Stab-Rabbit-coding/LibreServo_v4/PCB/RS485-CANFD-TPM-upgrade.md

# Hardware upgrade notes: isolated RS-485, isolated CAN-FD, TPM (SLB9672), MCU swap to STM32G431

> **Superseded again, 2026-08-10:** `U7` is now an Infineon OPTIGA™ Trust M V3
> secure element, not a TPM and not absent. See
> [`OPTIGA-Trust-M-secure-element.md`](OPTIGA-Trust-M-secure-element.md).

**Superseded in part**: the STM32G431 (`U1`) and the SLB9672 TPM (`U7`) described in §4/§5 below have since been replaced — `U1` is now an NXP S32K144, and `U7`/SLB9672 has been removed in favor of the S32K144's on-chip CSEc. See [`S32K144-MCU-swap.md`](S32K144-MCU-swap.md) for that pass. The isolated RS-485 (§2, `U5`/ADM2587E) and isolated CAN-FD (§3, `U6`/ADM3055E) content below is still current.

Engineering analysis and part recommendations for the LibreServo v2.3.1 board (`PCB/LibreServo-v2.3.1.sch`, MCU `U1`). This is a decision record and BOM proposal, not yet reflected in the EAGLE `.sch`/`.brd` files — see "Status / next steps" at the bottom for why, and what's needed to finish the layout.

**Decision: MCU is being swapped to STM32G431** (native FDCAN) — see §5. This is the bigger of the two alternatives originally laid out, chosen over adding an external MCP2518FD controller to the existing STM32F302K8U6.

Local datasheet copies for the three parts driving this change are in [`datasheets/`](datasheets/):

- [`ADM2582E-ADM2587E.pdf`](datasheets/ADM2582E-ADM2587E.pdf) — isolated RS-485 transceiver (§2)
- [`ADM3055E-ADM3057E.pdf`](datasheets/ADM3055E-ADM3057E.pdf) — isolated CAN-FD transceiver (§3)
- [`Infineon-SLB9672-TPM2.0-SPI-FW16.xx-datasheet.pdf`](datasheets/Infineon-SLB9672-TPM2.0-SPI-FW16.xx-datasheet.pdf) — TPM (§4)

## 1. MCU CAN-FD capability — verified: no (on the current `U1`, STM32F302K8U6)

`U1` is currently an **STM32F302K8U6** (STM32F302x6/x8 subfamily, Cat.2, UFQFPN32, 64 KB Flash) per `Test_LibreServo_v2.ioc`. This subfamily includes ST's classic **bxCAN** peripheral (CAN 2.0B, up to 1 Mbit/s, 8-byte frames only) — it does **not** implement **FDCAN** (the flexible-data-rate peripheral with BRS and up to 64-byte frames). FDCAN was introduced later, starting with the STM32F7/G0/G4/H7/L5 families ([AN5348, "Introduction to FDCAN peripherals for STM32 MCUs"](https://www.st.com/resource/en/application_note/an5348-introduction-to-fdcan-peripherals-for-stm32-mcus-stmicroelectronics.pdf) lists which families have it — F3 is not one of them).

Practically, this was moot either way for the *current* board: the schematic doesn't route `U1`'s CAN pins anywhere and there's no CAN transceiver in the BOM — CAN is unused silicon on this design today. This is exactly why §5 resolves the gap by swapping to a family that has FDCAN natively, rather than bolting a CAN-FD controller onto silicon that never had CAN wired up in the first place.

**Naming discrepancy worth flagging**: `PCB/LibreServo-v2.3_BOM.txt` lists `U1` as `STM32F301K8U6`, not `STM32F302K8U6` as configured in the `.ioc`. Datasheet: [STM32F301C6](https://www.st.com/resource/en/datasheet/stm32f301c6.pdf) (STM32F301x6/x8 subfamily — same die family, no isolated local copy here as `st.com` isn't reachable from this session's network policy). The two subfamilies share the same bxCAN-only (no FDCAN) conclusion above either way, but whoever does the schematic/footprint pass for the STM32G431 swap (§5) should first confirm which part is actually populated on existing boards (F301 vs. F302 — F302 additionally has a comparator/op-amp/USB set F301 lacks) so the new part is compared against the right baseline.

## 2. Isolated RS-485 transceiver (replaces `U5`, SIT3485EUA)

Current part: `U5`, SIT3485 half-duplex RS-485, MSOP-8, no isolation — the daisy-chain bus (`U$8`/`U$9`, JST-PH-4) shares digital GND directly with every other servo on the chain today.

**Recommendation: Analog Devices [ADM2587E](https://www.analog.com/ADM2587E/datasheet)** (USA, local copy: [`datasheets/ADM2582E-ADM2587E.pdf`](datasheets/ADM2582E-ADM2587E.pdf)). Single-chip signal *and* power isolation (iCoupler + isoPower — no external isolated DC/DC needed), half/full-duplex configurable, ±15 kV ESD, 2.5 kV rms isolation, single 3.3 V or 5 V supply on the logic side, 20-lead wide-body SOIC.

Why this over a signal-only isolator (e.g. TI [ISO1176](https://www.ti.com/product/ISO1176)): board space on this design is very tight, and a signal-only part still needs a separate isolated bus-side supply (push-pull driver + transformer, or a small isolated DC/DC module) — more parts, more area, more failure modes, for a part that's smaller/cheaper only in isolation. If SOIC-20 footprint area turns out to be the binding constraint, ISO1176 + an isolated supply is the fallback.

**Note on what "isolated" actually buys here**: the JST-PH-4 daisy-chain connector carries `Vmot`/`GND` (shared power distribution across the chain) alongside A/B. Isolating the transceiver splits the MCU/digital-logic ground from the RS-485 bus-side reference, which cuts ground-loop coupling and protects against bus miswiring/surges — but it does **not** isolate one servo's power domain from the next, since `Vmot`/`GND` still run straight through the connector by design. True node-to-node galvanic isolation would need the power distribution reworked too; that's a materially bigger change and is out of scope unless you want it.

## 3. Isolated CAN-FD transceiver (new)

**Recommendation: Analog Devices [ADM3055E](https://www.analog.com/media/en/technical-documentation/data-sheets/adm3055e-adm3057e.pdf)** (USA, local copy: [`datasheets/ADM3055E-ADM3057E.pdf`](datasheets/ADM3055E-ADM3057E.pdf)). Same iCoupler/isoPower approach as the ADM2587E above — 5 kV rms signal+power isolation, single 5 V supply, ISO 11898-2:2016 compliant, rated to 5 Mbps CAN FD (up to 12 Mbps demonstrated), 20-lead increased-creepage SOIC.

Picking the same vendor/technology family as the RS-485 part (§2) is deliberate: both isolate power internally, so neither needs its own isolated DC/DC design, and the two parts share a design/verification approach (same iCoupler isolation barrier characterization, same qualification data).

Fallback if SOIC-20 area is a problem: TI [ISO1042](https://www.ti.com/lit/ds/symlink/iso1042.pdf) (signal-only isolation, needs an external isolated supply — same tradeoff as ISO1176 above).

## 4. TPM: Infineon SLB9672

[SLB9672](https://www.infineon.com/assets/row/public/documents/30/49/infineon-slb9672-tpm20-spi-fw16.xx-ds-rev1-3-2024-11-18-datasheet-en.pdf) (Germany/EU, local copy: [`datasheets/Infineon-SLB9672-TPM2.0-SPI-FW16.xx-datasheet.pdf`](datasheets/Infineon-SLB9672-TPM2.0-SPI-FW16.xx-datasheet.pdf)) — TPM 2.0, SPI up to 33 MHz, PG-UQFN-32 package, internal power management (no explicit standby control needed).

Connects to `U1` on **SPI1**. On the new STM32G431 (§5), SPI1 is dedicated to the TPM alone — FDCAN is a separate hardware peripheral with its own TX/RX pins, so there's no bus-sharing between the TPM and the CAN-FD interface as there would have been with the external-controller alternative. Needs one GPIO for `~CS` and ideally one for an interrupt/ready line if the firmware wants event-driven reads rather than polling.

**Pin-budget flag**: still worth a full pin audit once the STM32G431 package/pinout is finalized in EAGLE (motor gate drivers, ADC current sense, encoder, USART1, RGB LED, oscillator, FDCAN TX/RX, and now SPI1 + TPM CS/IRQ all need a home) — the G431 has more GPIO headroom than the F302K8 it's replacing, but it's not unlimited, especially if a similarly small package (e.g. K6/K8, UFQFPN32) is kept for footprint/size parity.

## 5. MCU swap: STM32G431 for native FDCAN

Since §1 confirmed the current `U1` (STM32F302K8U6) has no FDCAN peripheral, an isolated CAN-FD *transceiver* alone isn't sufficient — something has to run the CAN-FD protocol/arbitration. Two options were evaluated; **STM32G431 is the one being taken forward**.

**Decision: [STMicroelectronics STM32G431](https://www.st.com/resource/en/datasheet/stm32g431c6.pdf)** series (e.g. STM32G431K6/K8, UFQFPN32) — HQ Plan-les-Ouates, Switzerland, fabs in France/Italy, **EU**. Cortex-M4 @ up to 170 MHz, native FDCAN peripheral (hardware bit-timing, message RAM, no CPU-mediated SPI framing), and is ST's official successor line to F3 — see [AN5094, "Migrating between STM32F334/303 and STM32G431/G474/G491"](https://www.st.com/resource/en/application_note/an5094-migrating-between-stm32f334303-and-stm32g431g474g491-mcus-stmicroelectronics.pdf).

| | Pros | Cons |
| --- | --- | --- |
| **Design impact** | Hardware FDCAN = precise bit timing, higher achievable throughput, no CPU cycles spent bit-banging SPI framing; frees SPI1 for the TPM alone; more GPIO/peripheral headroom than the F302K8 for future features | Full MCU swap: new schematic symbol/footprint, PCB relayout, and a firmware port (clock tree, HAL/peripheral register differences, re-mapping ADC/TIM/USART pins for existing PID/curve-generation/current-sense code) — the biggest-impact item in this whole upgrade |
| **Sourcing / "reach"** | ST has deep, redundant EU + global distribution (Digi-Key, Mouser, Farnell/element14, RS Components, Arrow); G4 is a current mainstream family with a long support runway, not a legacy part being phased out | Bigger BOM/unit-cost delta than the external-controller alternative; verification/requalification effort (schematic, layout, firmware, EMC) is proportionally larger |
| **REACH/RoHS** | ST publishes REACH SVHC and RoHS declarations for this family as standard | — |

**Alternative considered, not chosen — external CAN-FD controller on the existing MCU**: [Microchip MCP2518FD](https://ww1.microchip.com/downloads/aemDocuments/documents/OTH/ProductDocuments/DataSheets/External-CAN-FD-Controller-with-SPI-Interface-DS20006027B.pdf) (Microchip Technology Inc., Chandler, Arizona, **USA**) — SPI CAN-FD controller, would have sat between `U1`'s SPI1 and the ADM3055E transceiver from §3, keeping the STM32F302K8U6 in place. Pros were smallest change/lowest risk (no MCU footprint or firmware-port rework) and equally solid US sourcing (Digi-Key/Mouser/Arrow/Newark, EAR99, standard REACH/RoHS declarations). Cons were SPI-bus contention/latency vs. a hardware peripheral, a bus shared with the TPM, and CPU overhead servicing SPI transactions per frame instead of DMA-into-a-peripheral-FIFO — the STM32G431's native FDCAN avoids all of that, which is why it was picked instead.

**On "UK-sourced"**: there isn't a UK fabless/IDM vendor making a comparable CAN-FD controller or MCU — UK-based semiconductor firms in this space are mostly IP licensors (e.g. Arm) rather than chip suppliers. If UK sourcing specifically matters (e.g. procurement policy), the practical route is buying the STM32G431 through a UK distributor (Farnell/element14 or RS Components, both UK-headquartered) rather than a UK-origin die.

## Status / next steps

**Update**: the MCU swap, RS-485 transceiver swap, and CAN-FD transceiver addition described above have now been executed at the schematic (netlist) level in `PCB/LibreServo-v2.3.1.sch` — `U1` is now a `STM32G431` instance, `U5` is now an `ADM2587E` instance, and a new `U6` (`ADM3055E`) instance has been added and wired to `U1`'s FDCAN1 pins. **TPM (`SLB9672`) has now also been wired in, as `U7`** — see "TPM wiring" below for the pin-budget audit that drove how it was connected. This section records exactly what changed, the reasoning behind the wiring decisions, and what is still open. Those files are EAGLE 7.6 XML.

### What changed in the schematic

**Devicesets added** (symbol + a package-less placeholder `<device>`, same pattern EAGLE uses for its own `GND`/`+3V3`/`+7V` supply symbols in this library): `STM32G431`, `ADM2587E`, `ADM3055E`, `SLB9672`. No footprint/package exists for any of the four yet — see "Still missing" below, unchanged from before.

**`U1`: STM32F302K8U6 → STM32G431.** All of `U1`'s pre-existing nets were re-pinned onto the new symbol's actual UFQFPN32 pinout (pin-mapped from `datasheets/stm32g431c6.pdf` Table 12, not assumed to line up with the old F302 pinout — it doesn't, only some pins keep the same physical position). Net-for-net:

- Unchanged pins/nets: `VDD_1`/`VDD_2` (`+3V3`), `VSS_1`/`VSS_2`/`EP` (`GND`, note the two `VSS` pins swapped physical corners between the two parts — doesn't matter electrically), `VDDA/VREF+` (`VDDA-FILTRADO`) and the renamed `VSSA` (was `VSSA/VREF-`, `GND`) which both moved to new physical pins, `PF0-OSC_IN` (`CLK-8MHZ`, unchanged position), `PF1-OSC_OUT` and `PG10-NRST` (both still deliberately NC-marked, matching the existing external-oscillator/no-reset-button design), `PB8-BOOT0` (was `BOOT0`, still hard-tied to `GND` exactly as before — the G431 supports boot-mode selection via option bytes instead of the pin, but this schematic keeps the existing pin-strap behavior rather than assuming firmware will set that option byte), all of `PA0`–`PA10`, `PA13`–`PA15`, `PB0`, `PB5`–`PB7` keep their existing signal names (`SPI_CLK`/`SPI_IN`/`SPI_OUT`, `LED_RED/GREEN/BLUE`, `V_TEMP`, `V_CORRIENTE`, `V_BAT`, `PWM-1`/`PWM-3`, `EN-Q`, `USART1_TX/RX`, `SEL_SERIAL`, `SWDIO`/`SWCLK`), though several physically moved pin position (SPI/LED pins in particular).
- **Displaced by FDCAN1**: `PA11` and `PA12` are the *only* FDCAN1 RX/TX-capable pins broken out on the UFQFPN32 package (confirmed against the full alternate-function table in `datasheets/stm32g431c6.pdf` — `PD0`/`PD1`/`PB9`, the other FDCAN1-capable pins, aren't bonded out on this 32-pin package). Those two pins previously carried `PWM-2` and `PWM-4` (motor driver direction inputs). They're now `FDCAN1_RX` (`PA11`) and `FDCAN1_TX` (`PA12`); `PWM-2` and `PWM-4` were moved to `PB4`/`PB3`, which were both **already unused** on the F302 (explicitly NC-marked in the schematic, not carrying any signal) — so this was a like-for-like pin swap with no net pin-budget shortfall, not a compromise. `PA15` was the one spare/NC pin left after that swap — it's now used for `TPM_CS#` (see "TPM wiring" below), which means the UFQFPN32 package is **fully pinned out**: every one of `U1`'s 32 signal pins (plus `EP`) now carries a net, with zero spares remaining.
- **Caveat for firmware**: `PB3`/`PB4` don't have a `TIM1` alternate function on the G431 (unlike some of the pins they're replacing might have implied) — if the motor-PWM firmware needs a specific hardware timer channel on these two lines specifically, that's a firmware-side pin/timer re-assignment to check during the port, not something resolved by this schematic pass.

**`U5`: SIT3485 → ADM2587E** (§2). `RxD`/`TxD` stay wired to `USART1_RX`/`USART1_TX`; `RE`+`DE` are tied together onto `SEL_SERIAL` exactly like the old part's `RE̅`+`DE` (ADM2587E's `RE` is active-low, `DE` active-high — same convention, confirmed against `datasheets/ADM2582E-ADM2587E.pdf` Table 10). `VCC`/`GND1` (logic side) go to the existing `+3V3`/`GND` rails, per the datasheet's 3.3 V-or-5 V flexibility. Configured **half-duplex** per datasheet Figure 38 by tying `Y`+`A` together onto the existing `RS485_P` net and `Z`+`B` together onto `RS485_N`, so the daisy-chain connectors (`U$8`/`U$9`) didn't need to change. Added the datasheet-recommended isoPower support components (all from existing, footprint-complete library devicesets — `C-EU`, `FERRITE_BEAD_0603`): `VCC`/`GND1` decoupling (`C25`/`C26`), and the `VISOOUT`↔`VISOIN` isoPower loop (`B4` ferrite + `C27`–`C30`), referenced to a new, deliberately-isolated `RS485_ISO_GND` net that has **no connection to the board's main `GND`** — that separation *is* the isolation this part is being bought for; bridging it back to `GND` would defeat the purpose. One known limitation carried over from the already-merged symbol (not introduced by this pass): the ADM2587E symbol collapses all of the part's `GND2`-labeled pins (silicon pins 11, 14, 16, 20) onto a single schematic pin, but the datasheet calls out pin 16 as needing to stay off the same copper as pins 11/14 at layout time (EMI/noise separation, not a different net) — that distinction can't be expressed in the schematic as currently drawn and needs to be handled with copper-pour placement when the footprint/layout pass happens.

**`U6` (new): ADM3055E isolated CAN-FD transceiver** (§3). `TXD`/`RXD` go to the new `FDCAN1_TX`/`FDCAN1_RX` nets to `U1`. `VIO` → `+3V3` (matches MCU logic level). `SILENT`/`STBY` tied to `GND` (both are active-high with internal pull-downs — tying them low keeps the part in normal, always-on mode; nothing in this design drives them dynamically). `AUXIN`/`AUXOUT` are genuinely unused and marked NC, same convention as the rest of this schematic. Isolated side: `GND2` directly anchors a new `CANFD_ISO_GND` net (this part's symbol, unlike ADM2587E's, keeps `GND2`/`GNDISO` as separate pins, so the datasheet's noise-separation intent — `GNDISO` reaches the same isolated ground only through a ferrite, `B5` — could actually be followed here); `RS` is shorted to that same isolated ground for full-speed (non-slope-limited) operation, per datasheet §"RS Pin". `VISOOUT`↔`VISOIN` isoPower loop (`B6` + `C35`–`C38`) again referenced only to the isolated ground net, never to board `GND`. **`VCC` (the 4.5–5.5 V isoPower rail) is wired to a new `+5V_ISO_CANFD` net that nothing currently drives** — this board has no 5 V rail today (the existing `MPM3610`→`AP2112` chain only produces the ~3.8 V intermediate feeding `+3V3`; the raw `VMOT`/`+7V` rail is the unregulated battery/motor input voltage, not a regulated 5 V and not safe to feed into `VCC` directly). **A new small 5 V regulator (or a point-of-load buck/LDO tapped off `VMOT`) is required before this part can actually work — deliberately left as an open BOM/regulator-selection decision rather than guessed at here**, same way the MCU swap itself got its own dedicated write-up in §5 instead of being picked casually. `CANH`/`CANL` are brought out as labeled, currently-unterminated nets (`CANH`, `CANL`) — this schematic pass does **not** add a physical bus connector for them. The existing RS-485 daisy-chain connectors (`U$8`/`U$9`, JST-PH-4) are already fully pinned out (`+7V`/`GND`/`RS485_N`/`RS485_P`), and deciding how CAN-FD physically reaches the connector shell — new dedicated connector(s), a larger shared connector, chain topology — is a real mechanical/connector decision with its own tradeoffs that shouldn't be guessed at silently inside an unrelated commit.

**`U7` (new): SLB9672 TPM, and the pin-budget audit behind it** (§4). Before wiring anything, this pass did the "full pin audit" that §4 flagged as still outstanding: every one of `U1`'s 32 UFQFPN32 signal pins was checked against what it already carries. Result — after the FDCAN1 re-pin above, **exactly one pin was free: `PA15`**. Every SPI1-capable pin on this package (confirmed against the alternate-function table in `datasheets/stm32g431c6.pdf`) is already committed to something else:

| SPI1 pin group (AF5) | Pin | Already carries |
| --- | --- | --- |
| Default (NSS/SCK/MISO/MOSI) | `PA4`/`PA5`/`PA6`/`PA7` | `LED_GREEN`/`LED_BLUE`/`V_TEMP`/`V_CORRIENTE` |
| Remap (NSS/SCK/MISO/MOSI) | `PA15`/`PB3`/`PB4`/`PB5` | *(free)*/`PWM-4`/`PWM-2`/`SEL_SERIAL` |

Neither AF5 group is available as a clean 4-pin bus without bumping an already-load-bearing signal (an ADC input, a motor PWM line, or the RS-485 direction control) to some other pin — and there is no other free pin to bump it to. This is a hard constraint of the 32-pin package, not something a more careful net-name choice could route around. Given that, `SLB9672` was wired as follows rather than left unconnected:

- **`SCLK`/`MOSI`/`MISO` join the existing `SPI_CLK`/`SPI_OUT`/`SPI_IN` bus** that already runs from `U1` (`PA2`/`PA1`/`PA0`, bit-banged — those pins aren't SPI1-AF5-capable on the G431 either, so this was already a software/GPIO-driven bus, not a hardware SPI1 peripheral) out to connector `U$4` and to `POTEN_SERVO` (`U$6`). `TXD`→`SPI_OUT` (`U1`'s output leg) and `RXD`→`SPI_IN` (`U1`'s input leg) follow the same direction convention already used for that bus's other two legs. This is standard multi-drop SPI (shared clock/data, per-device chip select) rather than a new pattern — the bus already fans out to two endpoints before this change, so a third with its own `CS#` is consistent with how it's already used. **The caveat that matters for firmware**: this schematic didn't independently re-verify what's actually live on `U$4`/`U$6` — the sheet's own frame text nearby reads "CONNECTOR FFC@0.5mm" / "CONNECTORS JST-PH" with no port-level description of protocol/timing on this specific bus (that detail lives with whatever's wired to those connectors off-sheet, e.g. via `PCB-2`). **Whoever brings up TPM firmware needs to confirm nothing else on this bus is a continuously-polled, timing-sensitive peripheral before sharing it**, and in any case must make sure `TPM_CS#` is only asserted for the duration of a TPM transaction (deasserted/high the rest of the time) so it never contends with whatever else uses `SPI_CLK`/`SPI_IN`/`SPI_OUT`. Note this is a *different* bus from the AEAT-8800 encoder's SSI interface (`SPI_CLK_2`/`SPI_IN_2`/`SPI_OUT_2` via connector `U$3` to `U10` on the separate `PCB-2`) — that one was deliberately left alone since it's explicitly labeled as a live 1–1.2 MHz SSI link on the schematic and sharing it with TPM traffic would risk the position-feedback control loop.
- **`CS#` → the one free pin, `PA15`**, labeled `TPM_CS#`, with a 10 kΩ pull-up to `+3V3` (`R21`) per the datasheet's typical-schematic recommendation for designs (like this one) that don't guarantee `CS#` is at a defined level during power-on/reset — this board's `PG10-NRST` is deliberately NC (no reset circuit), so GPIOs are genuinely undriven until firmware configures them, making that pull-up the difference between "TPM ignores the bus until firmware takes over" and "TPM potentially responds to noise during boot."
- **`VDD`/`GND`** → `+3V3`/`GND`, with the datasheet-recommended decoupling (`C39` 1 µF bulk + `C40`–`C42` 3×100 nF, one per the part's collapsed `VDD`/`GND` pin group — the symbol merges the silicon's 3 physical `VDD` and 4 physical `GND` pins onto one schematic pin each, same simplification already accepted for `ADM2587E`'s `GND2`).
- **`NCI_VDD` → `+3V3`, `NCI_GND` → `GND`** — both per the datasheet's explicit recommendation for these two pins specifically (`Table 13`: "for future use, it is recommended to connect this pin to VDD/GND").
- **`RST#` → `+3V3`** (tied inactive/high). The datasheet shows it normally driven by a host reset signal, but this board doesn't have one to offer — matching the same "no reset button" precedent already accepted for `U1`'s own `PG10-NRST` — so it's tied off rather than left to the pin's weak internal pull-up alone.
- **`NC`, `NCI`, `PIRQ#`, `GPIO_00`/`GPIO_01`/`GPIO_02` → left unconnected** (`NC_MARKER`), matching this schematic's existing no-connect convention. `NC` and `NCI` per the datasheet (`NC` *must* float; `NCI` *may*). `PIRQ#` is open-drain with no internal pull-up and there's no spare GPIO left to route it to — this means firmware must **poll** the TPM rather than use an interrupt, which §4 already flagged as an optional nice-to-have rather than a requirement. `GPIO_00`–`GPIO_02` are the TPM's own auxiliary NV-controlled GPIOs, unused by this design; the datasheet says they may be left unconnected (internal pull-up).

### Still missing

Footprints/packages, devicesets (which pair a symbol with a footprint and map symbol pins to package pads), and 3D models for `STM32G431`, `ADM2587E`, `ADM3055E`, and `SLB9672` (PG-UQFN-32) — none of those exist yet in the `Propio` library, and none of the new instances (`U1`, `U5`, `U6`, `U7`) have board-side (`.brd`) placement yet. Footprint pad geometry (pitch, pad size, courtyard, creepage/clearance for the two isolated SOIC-20 parts) is exactly the kind of thing that can look "done" in an XML diff while being wrong on the board, so that pass still needs doing in EAGLE itself with visual verification against the datasheet mechanical drawings, rather than hand-authored blind. Recommend doing the footprint/deviceset/placement work in EAGLE, using this document and the now-wired schematic as the reference.

The MCU swap also means a firmware port, not just a layout change: `Src/main.c`, `Src/LS_*.c`, and `Test_LibreServo_v2.ioc` all target the STM32F302K8U6's HAL/register set today (ADC1, TIM1/15/16/17, USART1 pin mappings) and will need re-mapping onto the STM32G431's pinout (which, per the wiring above, is **not** a 1:1 physical remap of the old pin assignments), plus new FDCAN and — once the physical PWM pin/timer question above is settled — motor-PWM init code.

Open items for whoever does the layout/firmware pass:

- Footprints/devicesets/3D models and `.brd` placement for `STM32G431`, `ADM2587E`, `ADM3055E`, `SLB9672` (see above).
- Confirm `PB3`/`PB4` (now `PWM-2`/`PWM-4`) have adequate timer/PWM capability for the motor-drive firmware, or re-pin if a specific `TIM1` channel is required.
- Pick the exact STM32G431 part/package (K6 vs K8 flash size) — pinout is already fixed to UFQFPN32 by the schematic work above, so this is now just a flash-size choice, not a package/pin-count one.
- Confirm isolation-barrier creepage/clearance fits the existing board outline for the two SOIC-20 parts (ADM2587E, ADM3055E), and handle the ADM2587E `GND2` copper-separation caveat above at layout time.
- Select and add a 5 V regulator for the new `ADM3055E` isoPower `VCC` rail (`+5V_ISO_CANFD` net) — nothing on the board produces 5 V today.
- Decide the physical CAN-FD bus connector strategy (extend the existing JST-PH-4 daisy chain, add dedicated connector(s), etc.) and terminate the `CANH`/`CANL` nets accordingly.
- Decide whether the isolated-power caveat in §2 (shared `Vmot`/GND on the daisy-chain connector) needs to be addressed, or is acceptable as-is.
- **Confirm what's actually live on the shared `SPI_CLK`/`SPI_IN`/`SPI_OUT` bus** (`U$4`, `POTEN_SERVO`/`U$6`) before bringing up TPM firmware, and implement bus arbitration around `TPM_CS#` (see "TPM wiring" above) — this is the one TPM decision this pass couldn't fully close out from the schematic alone, since the bus's other consumers aren't characterized on-sheet.
- If a fully dedicated TPM SPI bus (rather than sharing `SPI_CLK`/`SPI_IN`/`SPI_OUT`) turns out to be a hard requirement, the only way to get one is a higher-pin-count STM32G431 package (e.g. LQFP48) — the UFQFPN32 chosen for footprint parity has no free pins left after this pass to give TPM a dedicated bus, and that's a footprint/size tradeoff, not something to change silently.
- `PIRQ#` is left unconnected for the same reason (no spare GPIO) — confirm polling the TPM status register is acceptable for the intended use case, or free up a pin (e.g. by dropping something from the board) if interrupt-driven reads are actually needed.
- Place `R21` (TPM `CS#` pull-up) and the TPM decoupling caps (`C39`–`C42`) close to `U7`'s actual pins once its footprint exists — their schematic positions are placeholders.
