Stab-Rabbit-coding/LibreServo_v4/PCB/kicad/LibreServo-v4.0.0.kicad_sch

## KiCad design PCB/kicad/LibreServo-v4.0.0.kicad_sch (2026-10-18)

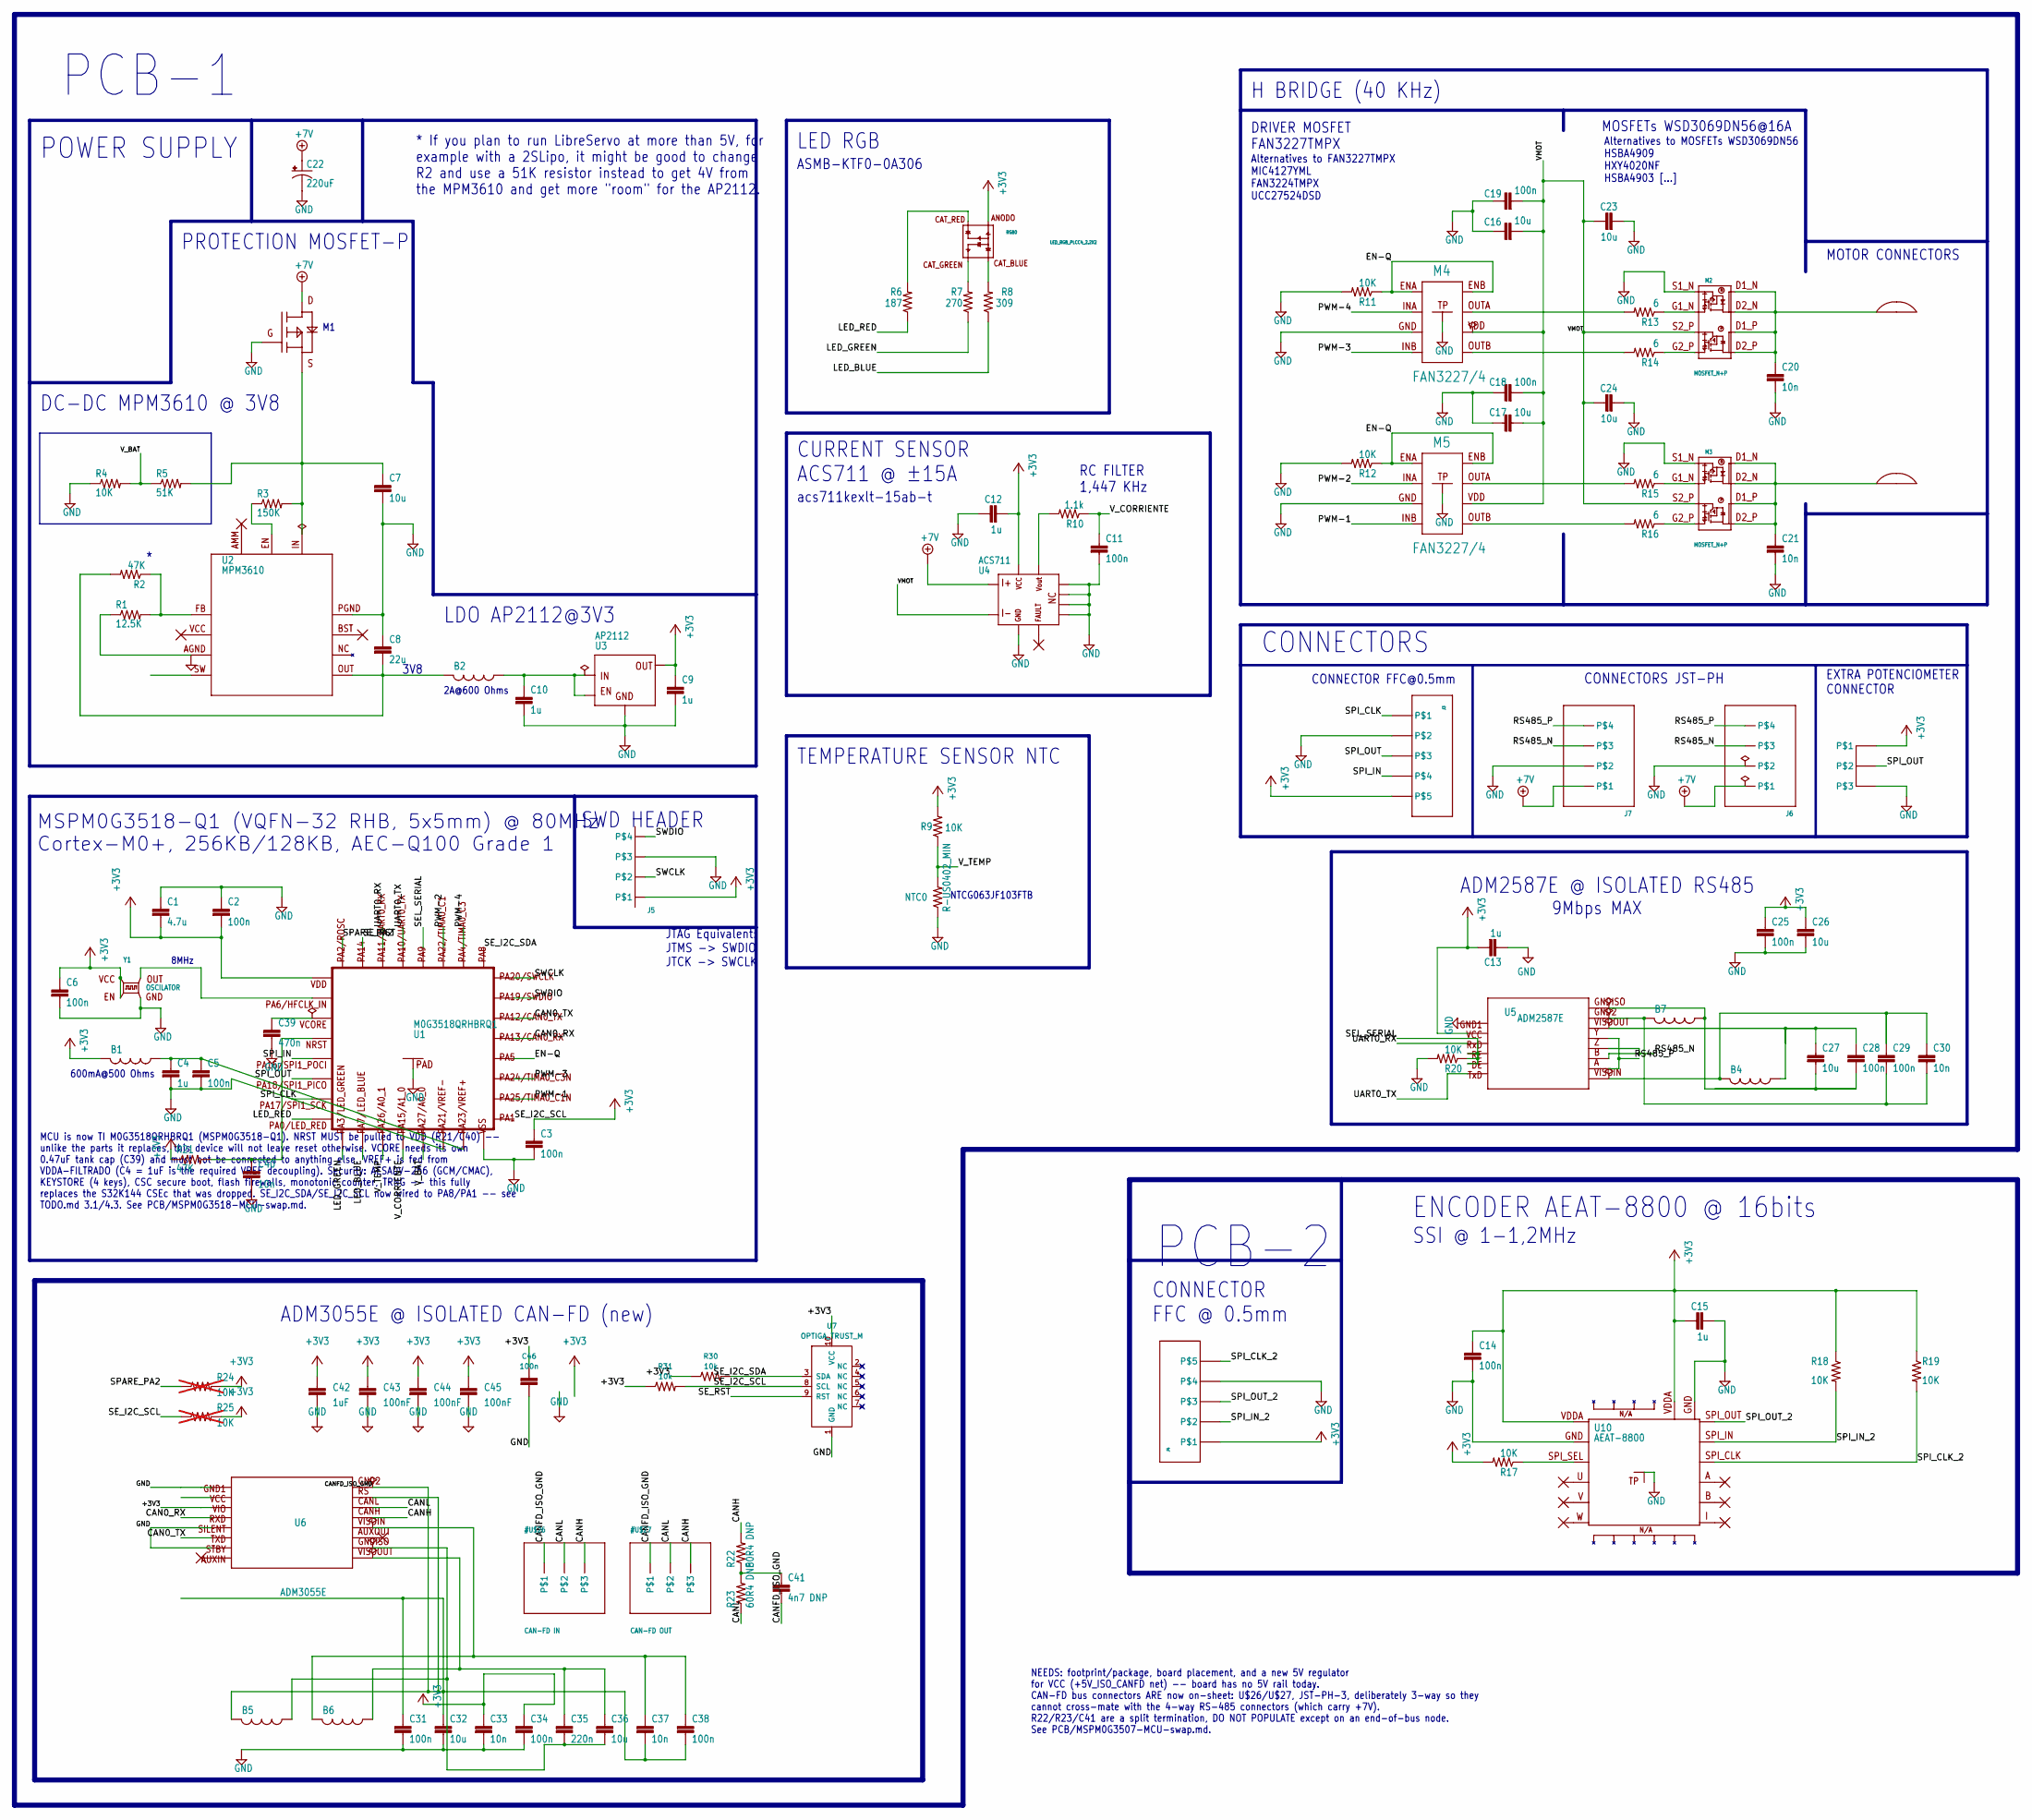
[picture p1: schematic LibreServo-v4.0.0.kicad_sch]

Parts:
B1: FERRITE_BEAD_0402; 0402
B2, B4, B5, B6, B7: FERRITE_BEAD_0603; 0603
C1: 4.7u; 0402
C2, C3, C5, C6, C11, C14, C18, C19, C25, C28, C29, C31, C34, C38, C46: 100n; 0402
C4, C9, C10, C12, C13, C15: 1u; 0402
C7, C16, C17, C23, C24, C26, C27, C32, C36: 10u; 0603
C8: 22u; 1206
C20, C21, C30, C33, C37, C40: 10n; 0402
C22: 220uF; E2,5-6_MIN
C35: 220n; 0402
C39: 470n; 0402
C41: 4n7 DNP; 0402
C42: 1uF; 0603
C43, C44, C45: 100nF; 0402
J1, J2: SLOT; SERVO_SLOT
J3, J4: FFC-5; FFC-5-0.5
J5: HEADER_4_1.27_0.3
J6, J7: JST_PH-4_HOLEB; JST_PH-4_HOLE_B
M1: M1; SOT23
M2, M3: MOSFET_N+P; DFN5X6
M4, M5: FAN3227/4; MLP8
NTC0: R-US0402_MIN; 0402_MIN
R1: 12.5K; 0402
R2, R21: 47K; 0402
R3: 150K; 0402
R4, R9, R11, R12, R17, R18, R19, R20: 10K; 0402
R5: 51K; 0402
R6: 187; 0402
R7: 270; 0402
R8: 309; 0402
R10: 1.1k; 0402
R13, R14, R15, R16: 6; 0402
R22, R23: 60R4 DNP; 0402
R24, R25: 10K; 0402; not fitted
R30, R31: 10k; 0402
RGB0: LED_RGB_PLCC4_2.2X2; PLCC-4_2.2X2
RV1: POTEN_SERVO
U1: M0G3518QRHBRQ1; Texas_RHB0032E_VQFN-32-1EP_5x5mm_P0.5mm_EP3.45x3.45mm
U2: MPM3610; MPM36XX
U3: AP2112; SOT25
U4: ACS711; ACS711-QFN
U5: ADM2587E; SOIC-20W_7.5x12.8mm_P1.27mm
U6: ADM3055E; SOIC-20W_7.5x12.8mm_P1.27mm
U7: OPTIGA_TRUST_M; Infineon_PG-USON-10-2-4_3x3mm_P0.5mm_EP1.7x2.5mm
U10: AEAT-8800; QFN24
Y1: OSCILATOR; OSC-2X1.6

Connections:
+3V3: B1.2, C1.2, C2.2, C3.1, C6.1, C9.1, C12.2, C13.2, C14.1, C15.1, C25.1, C26.1, C33.1, C34.1, C42.1, C43.1, C44.1, C45.1, C46.1, J3.P$5, J4.P$1, J5.P$1, R9.2, R17.2, R18.1, R19.1, R21.1, R24.2, R25.2, R30.1, R31.1, RGB0.P$1 (ANODO), RV1.P$1, U1.4 (VDD), U3.5, U4.P$12, U5.3 (VCC), U6.3 (VIO), U7.10 (VCC), U10.P$14, U10.P$19, Y1.P$1 (EN), Y1.P$4 (VCC)
+7V: C22.+, J6.P$1, J7.P$1, M1.P$2 (D), U4.P$1
CAN0_RX: U1.17 (PA13/CAN0_RX), U6.4 (RXD)
CAN0_TX: U1.16 (PA12/CAN0_TX), U6.6 (TXD)
CAN-FD IN: B5.2, C31.1, C32.1, C37.2, C38.2, C41.2, R22.2, R23.1, U6.9 (GND2), U6.10 (RS), U6.11 (CANL), U6.12 (CANH)
EN-Q: M4.P$1 (ENA), M4.P$8 (ENB), M5.P$1 (ENA), M5.P$8 (ENB), R11.1, R12.1, U1.9 (PA5)
GND: C1.1, C2.1, C3.2, C4.2, C5.2, C6.2, C7.2, C8.1, C9.2, C10.2, C11.2, C12.1, C13.1, C14.2, C15.2, C16.1, C17.1, C18.1, C19.1, C20.2, C21.2, C22.-, C23.2, C24.2, C25.2, C26.2, C31.2, C32.2, C33.2, C34.2, C39.2, C40.2, C42.2, C43.2, C44.2, C45.2, C46.2, J3.P$2, J4.P$4, J5.P$3, J6.P$2, J7.P$2, M1.P$1 (G), M2.P$1 (S1_N), M3.P$1 (S1_N), M4.P$3 (GND), M4.P$9 (TP), M5.P$3 (GND), M5.P$9 (TP), NTC0.1, R1.1, R4.1, R11.2, R12.2, R20.2, RV1.P$3, U1.5 (VSS), U1.25 (PA21/VREF-), U1.33 (PAD), U2.P$3 (P$3_AGND), U2.P$12 (P$8_PGND), U2.P$13 (P$8_PGND), U2.P$14 (P$8_PGND), U3.2, U4.P$5, U4.P$7, U4.P$8, U4.P$9, U4.P$10, U5.2 (GND1), U6.1 (GND1), U6.5 (SILENT), U6.7 (STBY), U7.1 (GND), U10.P$13, U10.P$20, U10.P$25, Y1.P$2 (GND)
LED_BLUE: R8.1, U1.11 (PA7/LED_BLUE)
LED_GREEN: R7.1, U1.7 (PA3/LED_GREEN)
LED_RED: R6.1, U1.1 (PA0/LED_RED)
NC_MARKER: U2.P$2 (P$2_VCC), U2.P$11 (P$7_BST), U2.P$18 (P$11_AMM), U4.P$6, U6.8 (AUXIN), U6.14 (AUXOUT), U10.P$7, U10.P$8, U10.P$9, U10.P$22, U10.P$23, U10.P$24
unnamed: B1.1, C4.1, C5.1, U1.27 (PA23/VREF+)
unnamed: B2.1, C10.1, U3.1, U3.3
unnamed: B2.2, C8.2, R2.2, U2.P$7 (P$5_OUT), U2.P$8 (P$5_OUT), U2.P$9 (P$5_OUT)
unnamed: B4.1, C27.1, C28.1, U5.9 (VISOOUT)
unnamed: B4.2, C29.1, C30.1, U5.14 (VISOIN)
unnamed: B5.1, C35.2, C36.2, U6.15 (GNDISO)
unnamed: B6.1, C35.1, C36.1, U6.16 (VISOOUT)
unnamed: B6.2, C37.1, C38.1, U6.13 (VISOIN)
unnamed: B7.1, C27.2, C28.2, U5.1 (GNDISO)
unnamed: B7.2, C29.2, C30.2, U5.8 (GND2)
unnamed: C7.1, M1.P$3 (S), R3.2, R5.2, U2.P$16 (P$9_IN)
unnamed: C20.1, J1.P$1, M2.P$5 (D2_P), M2.P$6 (D1_P), M2.P$7 (D2_N), M2.P$8 (D1_N), M2.P$9 (D1_N)
unnamed: C21.1, J2.P$1, M3.P$5 (D2_P), M3.P$6 (D1_P), M3.P$7 (D2_N), M3.P$8 (D1_N), M3.P$9 (D1_N)
unnamed: C39.1, U1.32 (VCORE)
unnamed: C40.1, R21.2, U1.3 (NRST)
unnamed: C41.1, R22.1, R23.2
unnamed: M2.P$2 (G1_N), R13.1
unnamed: M2.P$4 (G2_P), R14.1
unnamed: M3.P$2 (G1_N), R15.1
unnamed: M3.P$4 (G2_P), R16.1
unnamed: M4.P$5 (OUTB), R14.2
unnamed: M4.P$7 (OUTA), R13.2
unnamed: M5.P$5 (OUTB), R16.2
unnamed: M5.P$7 (OUTA), R15.2
unnamed: R1.2, R2.1, U2.P$1 (P$1_FB)
unnamed: R3.1, U2.P$17 (P$10_EN)
unnamed: R6.2, RGB0.P$4 (CAT_RED)
unnamed: R7.2, RGB0.P$3 (CAT_GREEN)
unnamed: R8.2, RGB0.P$2 (CAT_BLUE)
unnamed: R10.2, U4.P$11
unnamed: R17.1, U10.P$21
unnamed: U1.10 (PA6/HFCLK_IN), Y1.P$3 (OUT)
unnamed: U2.P$4 (P$4_SW), U2.P$5 (P$4_SW), U2.P$6 (P$4_SW)
unnamed: U2.P$10 (P$6_NC), U2.P$15 (P$6_NC)
PWM-1: M5.P$4 (INB), U1.29 (PA25/TIMA0_C1N)
PWM-2: M5.P$2 (INA), U1.26 (PA22/TIMA0_C1)
PWM-3: M4.P$4 (INB), U1.28 (PA24/TIMA0_C3N)
PWM-4: M4.P$2 (INA), U1.8 (PA4/TIMA0_C3)
RS485_N: J6.P$3, J7.P$3, U5.11 (Z), U5.12 (B)
RS485_P: J6.P$4, J7.P$4, U5.10 (Y), U5.13 (A)
SEL_SERIAL: R20.1, U1.13 (PA9), U5.5 (RE), U5.6 (DE)
SE_I2C_SCL: R25.1, R31.2, U1.2 (PA1), U7.8 (SCL)
SE_I2C_SDA: R30.2, U1.12 (PA8), U7.3 (SDA)
SE_RST: U1.18 (PA14), U7.9 (RST)
SPARE_PA2: R24.1, U1.6 (PA2/ROSC)
SPI_CLK: J3.P$1, U1.21 (PA17/SPI1_SCK)
SPI_CLK_2: J4.P$5, R19.2, U10.P$10
SPI_IN: J3.P$4, U1.20 (PA16/SPI1_POCI)
SPI_IN_2: J4.P$2, R18.2, U10.P$11
SPI_OUT: J3.P$3, RV1.P$2, U1.22 (PA18/SPI1_PICO)
SPI_OUT_2: J4.P$3, U10.P$12
SWCLK: J5.P$2, U1.24 (PA20/SWCLK)
SWDIO: J5.P$4, U1.23 (PA19/SWDIO)
UART0_RX: U1.15 (PA11/UART0_RX), U5.4 (RxD)
UART0_TX: U1.14 (PA10/UART0_TX), U5.7 (TxD)
VMOT: C16.2, C17.2, C18.2, C19.2, C23.1, C24.1, M2.P$3 (S2_P), M3.P$3 (S2_P), M4.P$6 (VDD), M5.P$6 (VDD), U4.P$3
V_BAT: R4.2, R5.1, U1.31 (PA27/A0_0)
V_CORRIENTE: C11.1, R10.1, U1.19 (PA15/A1_0)
V_TEMP: NTC0.2, R9.1, U1.30 (PA26/A0_1)

Notes on the sheet:
600mA@500 Ohms
CONNECTOR FFC@0.5mm
RC FILTER 1,447 KHz
ASMB-KTF0-0A306
Alternatives to MOSFETs WSD3069DN56 HSBA4909 HXY4020NF HSBA4903 [...]
LED RGB
ENCODER AEAT-8800 @ 16bits
EXTRA POTENCIOMETER CONNECTOR
NEEDS: footprint/package, board placement, and a new 5V regulator for VCC (+5V_ISO_CANFD net) -- board has no 5V rail today. CAN-FD bus connectors ARE now on-sheet: U$26/U$27, JST-PH-3, deliberately 3-way so they cannot cross-mate with the 4-way RS-485 connectors (which carry +7V). R22/R23/C41 are 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
H BRIDGE (40 KHz)
CONNECTORS
DC-DC MPM3610 @ 3V8
LDO AP2112@3V3
acs711kexlt-15ab-t
8MHz
MOTOR CONNECTORS
ADM2587E @ ISOLATED RS485
MOSFETs WSD3069DN56@16A
POWER SUPPLY
PCB-2
PCB-1
JTAG Equivalent: JTMS -> SWDIO JTCK -> SWCLK
9Mbps MAX
DRIVER MOSFET FAN3227TMPX
Alternatives to FAN3227TMPX MIC4127YML FAN3224TMPX UCC27524DSD
CONNECTORS JST-PH
SWD HEADER
PROTECTION MOSFET-P
SSI @ 1-1,2MHz
MCU is now TI M0G3518QRHBRQ1 (MSPM0G3518-Q1). NRST MUST be pulled to VDD (R21/C40) -- unlike the parts it replaces, this device will not leave reset otherwise. VCORE needs its own 0.47uF tank cap (C39) and must not be connected to anything else. VREF+ is fed from VDDA-FILTRADO (C4 = 1uF is the requ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
2A@600 Ohms
MSPM0G3518-Q1 (VQFN-32 RHB, 5x5mm) @ 80MHz Cortex-M0+, 256KB/128KB, AEC-Q100 Grade 1
3V8
CONNECTOR FFC @ 0.5mm
CURRENT SENSOR ACS711 @ ±15A
* If you plan to run LibreServo at more than 5V, for example with a 2SLipo, it might be good to change R2 and use a 51K resistor instead to get 4V from the MPM3610 and get more "room" for the AP2112.
NTCG063JF103FTB
ADM3055E @ ISOLATED CAN-FD (new)
TEMPERATURE SENSOR NTC
