Stab-Rabbit-coding/LibreServo_v4/(commit log)

2026-08-10 feat(pcb): replace the SLB9672 TPM with an OPTIGA Trust M secure element (U7)
    The servo needs an independent hardware root of trust, not a TPM stack. U7 was
    an Infineon SLB9672 TPM 2.0 -- a 32-pin SPI platform-integrity module built
    around PCRs and attestation. It is replaced by an Infineon OPTIGA(TM) Trust M
    V3 (SLS 32AIA010ML, ETR -40..+105C, PG-USON-10-2,-4, 3x3mm), a 10-pin I2C key
    vault with a crypto engine.
    This is NOT a like-for-like substitution and the schematic no longer pretends
    otherwise: different device class, different bus, different pin count. The SPI
    interface and all six TPM-specific nets are gone.
    Schematic changes (tools/swap_slb9672_for_optiga.py, committed so the edit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
    [LibreServo-v4.0.0.kicad_sch]
2026-08-10 docs: add repo governance and record the Trust M swap
    The repository had no AGENTS.md, REFERENCES.md, TODO.md, or PROJECT_INDEX.md,
    so the secure-element change had no citation discipline to attach to. This adds
    that scaffolding and writes the change up against it.
    Governance:
    - AGENTS.md adopted from the sister Open-Secure-ESC project, reproduced with
    only the project description changed and carrying a provenance note saying
    so. The two designs share a hardware root of trust and should share one
    evidentiary standard. Upstream LibreServo is not governed by it.
    - CLAUDE.md stub pointing AI agents at AGENTS.md.
    - .markdownlint-cli2.jsonc mirroring the sister repo, with MD033/MD045/MD041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
2026-08-22 Resolve TODO items 1-4: REFERENCES.md intake, MCU pin/part fixes, secure element wiring, security protocol decisions
    TODO §1 (Governance & Documentation):
    - Complete the REFERENCES.md intake (1.4a-c): add IEEE entries [46]-[52] for
    the MSPM0G351x-Q1 datasheet, both isolated transceiver datasheets, and the
    TI MSPM0 application notes, each read directly from the local PDFs with
    verified section/page citations. Found and recorded that the errata doc
    slaz742g.pdf does not apply to the current MCU die (wrong family).
    - Audit README.md for uncited claims (1.6): fixed an unsourced "9Mbps" bus
    speed claim that didn't match either transceiver's real datasheet figures,
    and marked WSD3069D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
    [LibreServo-v4.0.0.kicad_sch]
2026-09-08 chore(kicad): baseline reformat + plan for ERC/DRC clean-up
    KiCad's own alphabetical lib_symbols reordering from an earlier GUI
    session (confirmed no data loss: 65 lib symbols / 198 component
    instances identical before and after). Also gitignores the KiCad
    auto-backup and kicad-skill analysis-cache directories, and adds the
    implementation plan for bringing the v4 schematic/PCB to ERC/DRC-clean,
    manufacture-ready state (TODO.md 5.0-5.3, 6.1-6.3).
    [LibreServo-v4.0.0.kicad_sch]
2026-09-08 fix(sch): annotate 9 orphaned EAGLE-import components (U1)
    U\$1/U\$2 (SLOT/SERVO_SLOT) -> J1/J2, U\$3/U\$4 (FFC-5) -> J4/J3,
    U\$5 (HEADER_4_1.27_0.3) -> J5, U\$6 (POTEN_SERVO) -> RV1,
    U\$8/U\$9 (JST_PH-4_HOLEB, RS-485 daisy-chain in/out) -> J6/J7,
    U\$100 (OSCILATOR) -> Y1. Matches the existing #-prefix CAN-FD IN/OUT
    JST connector pair's convention (in/out gets sequential same-family
    refs). Resolves the "schematic has annotation errors" netlist-export
    warning (TODO.md 6.1).
    Verified: 117 components before and after, 0 duplicate reference
    designators, 0 remaining U\$-form references (analyze_schematic.py).
    ERC violation count unchanged (64) confirming no wiring was disturbed.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
    [LibreServo-v4.0.0.kicad_sch]
2026-09-09 fix(sch): separate U5's RS-485 differential pair (Y+A / Z+B)
    An EAGLE-import wiring defect had all four of U5 (ADM2587E)'s RS-485
    pins -- Y, Z, A, B -- electrically bussed onto one node (via a stray
    wire bridging the "RS485_P"-labeled bus to the "RS485_N"-labeled wire
    at (430.53,278.13)-(430.53,279.4), plus B tapping directly into the
    Y/A junction instead of the Z/N side). This shorted the two
    differential-pair legs together -- the bus could not have worked.
    Removed the stray P/N bridge wire and B's incorrect tap into the P-bus
    junction; rewired B onto the existing Z/RS485_N wire run instead,
    matching this repo's own documented design intent
    (PCB/RS485-CANFD-TPM-upgrade.md SS2: "Y+A togethe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
    [LibreServo-v4.0.0.kicad_sch]
2026-09-09 fix(sch): separate U6's CAN-FD logic pins onto their correct nets
    An EAGLE-import defect had bussed 5 of U6 (ADM3055E)'s pins --
    GND1, VCC, VIO, RXD, TXD -- onto one continuous wire trunk that
    ultimately reached a +3V3 power symbol, silently shorting the chip's
    logic ground, its 5V isoPower input, its 3.3V IO supply, and both its
    CAN-FD RX/TX signal pins together. Each pin already had a correctly-
    named local label sitting on that same over-merged wire (GND, +3V3,
    CAN0_RX, CAN0_TX, +5V_ISO_CANFD) -- the labels were right, the
    underlying wire topology was wrong, exactly the
    "similar_label_and_power"/"multiple_net_names" class of EAGLE-import
    defect this repo's TODO.md SS6 already catalogs.
    R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
    [LibreServo-v4.0.0.kicad_sch]
2026-09-09 chore(sch): embed the standard KiCad power:PWR_FLAG symbol definition
    Adds the library symbol only (no instances yet) -- copied verbatim
    from KiCad 9's own power.kicad_sym so the project has a local copy
    consistent with the rest of this schematic's self-contained
    lib_symbols table, rather than depending on the global "power"
    library nickname resolving the same way on every machine that opens
    this file. Enables the next commit's PWR_FLAG placements on U5/U6's
    isolated-side nets and the board's +7V/GND rails (TODO.md 6.2).
    [LibreServo-v4.0.0.kicad_sch]
2026-09-09 fix(sch): add PWR_FLAG on 10 legitimately-external/isolated supply nets
    Places power:PWR_FLAG instances on the nets ERC correctly reports as
    "power_pin_not_driven" because nothing in the schematic supplies them
    from a real driven output pin -- they're genuinely externally-sourced
    or internally isoPower-generated:
    - U5 (ADM2587E) GNDISO / GND2 / VISOIN / VISOOUT -- isolated-side
    supply generated by the part's own integrated isoPower converter,
    not modeled as a driving pin on the symbol.
    - U6 (ADM3055E) the same 4 isolated-side nets, mirroring U5.
    - Board +7V and GND, sourced from the external battery/motor
    connector (J6/J7), which this schematic correctly can't infer as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
    [LibreServo-v4.0.0.kicad_sch]
2026-09-10 fix(sch): resolve power-tree ERC errors (AGND, VCORE, VMOT mislabel, PWR_FLAGs)
    Multiple independent fixes, each verified via kicad-cli sch erc +
    sch export netlist before combining:
    - U2 (MPM3610 buck) AGND (P\$3) was a genuinely isolated 2-pin island
    (only tied to feedback resistor R1, never reaching board GND). Added
    a GND symbol at the same point -- the datasheet-preferred treatment
    (a dedicated low-noise star-ground point for the feedback divider,
    distinct from the switching PGND) is a PCB-layout copper concern,
    not a schematic connectivity one; MPM3610 datasheet not locally
    available to verify further, tracked as a new TODO item.
    - U1 VCORE (pin 32): added a PWR_FLAG. This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
    [LibreServo-v4.0.0.kicad_sch]
2026-09-10 docs(todo): close 6.1, update 6.2/6.3 with this session's ERC findings
    Records the two real wiring defects found and fixed (RS-485 differential-
    pair short on U5, CAN-FD bus short on U6), the VMOT/+5V mislabeling bug,
    the 15 PWR_FLAG placements and their individual rationale, and the 6
    remaining ERC errors' disposition: 3 are documented waivers (verified
    correct via netlist tracing or explicitly deferred by this repo's own
    prior design record), 3 need a datasheet this repo doesn't have yet
    (new item 1.4.g: MPM3610-class part, SERVO_SLOT connector drawing).
    ERC: 64 violations / 19 errors (session baseline) -> 56 / 6, all
    changes verified via kicad-cli sch erc + sch export netlist before
    each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
2026-09-12 Close TODO 7.3 (I2C clock verified, CLKSEL bug fixed); advance 4.13
    7.3: Verified LS_I2C_FUNCTIONAL_CLK_HZ=32MHz against [46]/[52] (SYSOSC BASE
    frequency, I2C0's PD0/ULPCLK bus-clock assignment, and the reset-default
    MCLK source). Found and fixed a real bug in the same pass: I2Cx.CLKSEL
    resets to 0x0 (neither BUSCLK nor MFCLK selected), so I2C0 had no
    functional clock source at all — pal_i2c_init() now writes
    CLKSEL.BUSCLK_SEL explicitly instead of relying on a reset value that
    didn't do what the old comment assumed.
    4.13: Recorded a cited design decision (Data Bank Protection region for
    the platform binding secret, SWD Security Level 1 for debug lockdown,
    static NONMAIN write-protection)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
    [ls_board.h, ls_mspm0_i2c_regs.h, ls_pal_i2c.c]
2026-09-13 Intake WSD3069DN56 datasheet, partially close TODO 1.4.e
    The user supplied the Winsok Semiconductor WSD3069DN56 datasheet
    directly (Rev 2, Apr. 2019), after this session found neither an
    uploaded copy nor network access to fetch one itself. Cataloged as
    REFERENCES.md [60].
    Every figure checked out: the README's "16A continuous" claim and the
    BOM's "1.5V@250uA" / "15mΩ@10V,10A" figures all match the datasheet's
    Product Summary, Absolute Maximum Ratings and Electrical Characteristics
    tables exactly. Removed the UNVERIFIED marker on that one README line;
    no correction was needed.
    AEAT-8800 and ACS711 remain open under 1.4.e — datasheet URLs were
    located (docs.broadcom.com, allegromicro.com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
2026-09-13 Intake AEAT-8800-Q24 datasheet, further advance TODO 1.4.e
    The user supplied the Broadcom AEAT-8800-Q24 datasheet directly
    (pub-005892, May 17 2017), same as WSD3069DN56 before it. Cataloged
    as REFERENCES.md [61].
    The README's "16 bits of resolution! 360 degrees" claim matches the
    datasheet ("full 360 degrees of rotation", "Selectable 10, 12, 14, or
    16 bits of absolute resolution") — with a caveat now on record: 16
    bits is the top of a selectable, one-time-programmable range, not a
    fixed rating, which the README's phrasing doesn't make explicit.
    Package (QFN-24) and interface (3-wire SSI + incremental A/B/I)
    cross-checked against the BOM and PCB/RS485-CANFD-TPM-upgrade.md —
    consistent.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
2026-09-13 Intake ACS711 datasheet, close TODO 1.4.e
    The user supplied the Allegro MicroSystems ACS711 datasheet directly
    (ACS711A-DS Rev. 9, Jan. 24 2025), completing the set alongside
    WSD3069DN56 and AEAT-8800-Q24. Cataloged as REFERENCES.md [62].
    Unlike the other two, this one needed an actual correction: README's
    "±15A" was never an exact figure the part offers. The Selection Guide
    shows the BOM's exact part (ACS711KEXLT-15AB-T) is rated ±15.5A, and
    the BOM itself already had that correct figure — only the README had
    drifted from it. Corrected to "±15.5A" with citation.
    TODO 1.4.e is now closed: all three parts flagged UNVERIFIED in the
    2026-08-22 audit (1.6) are intaken and cited.
    Co-Autho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
2026-09-18 docs(cr): supersede the LibreServo_v4.1-TC tilt-controller CR; close TODO §8
    The Serenity nacelle-tilt controller is an Open-Secure-ESC build
    (Open-Secure-ESC/builds/6s/10A/BRUSHED_CAN_485_isolation/), not a
    LibreServo variant — a variant would fork v4 away from its upstream and
    break the attribution chain (Serenity-UAV plan 2026-09-17-001, KTD1). The
    CR is kept as the decision record its figures were harvested from, with a
    SUPERSEDED banner and redirect; TODO §8 items 8.1-8.7 close as superseded.
    v4.0.0 is untouched.
    AI note: authored by Claude Opus 5 (claude-opus-5) under the direction of
    Steve Griffing, PE(CSE), CISSP-ISSEP, CPP.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
2026-09-28 docs: adopt CNAF M-3710.7 warning/caution/note and shall/should/may/will wording
    Promulgates [60] (CNAF M-3710.7 SS1.5-1.6) callout-severity and
    requirement-verb conventions into AGENTS.md sec 4a, with a project addition
    on active-vs-passive voice. Adds a pre-commit check
    (tools/precommit_doc_wording.py) that blocks ad hoc callout labels and
    flags "will"-as-requirement usage as advisory, wired via .githooks/pre-commit
    (git config core.hooksPath .githooks).
