Stab-Rabbit-coding/LibreServo_v4/(notices)

Notices in the files:
PCB/kicad/LibreServo-v4.0.0.kicad_sch:
Fork of LibreServo v2.3.1 (CC BY-SA 4.0), https://www.libreservo.com/en
